Dmotley4/GimbalProject/BOM.JPG

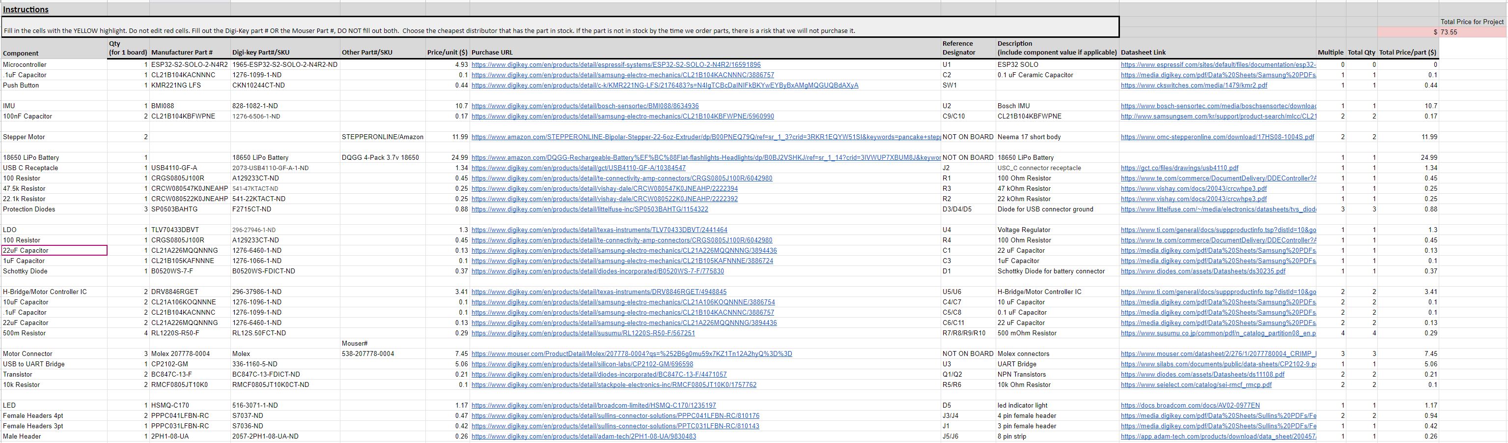
BOM.JPG
