Dmotley4/GimbalProject/Close_up_BOM.JPG

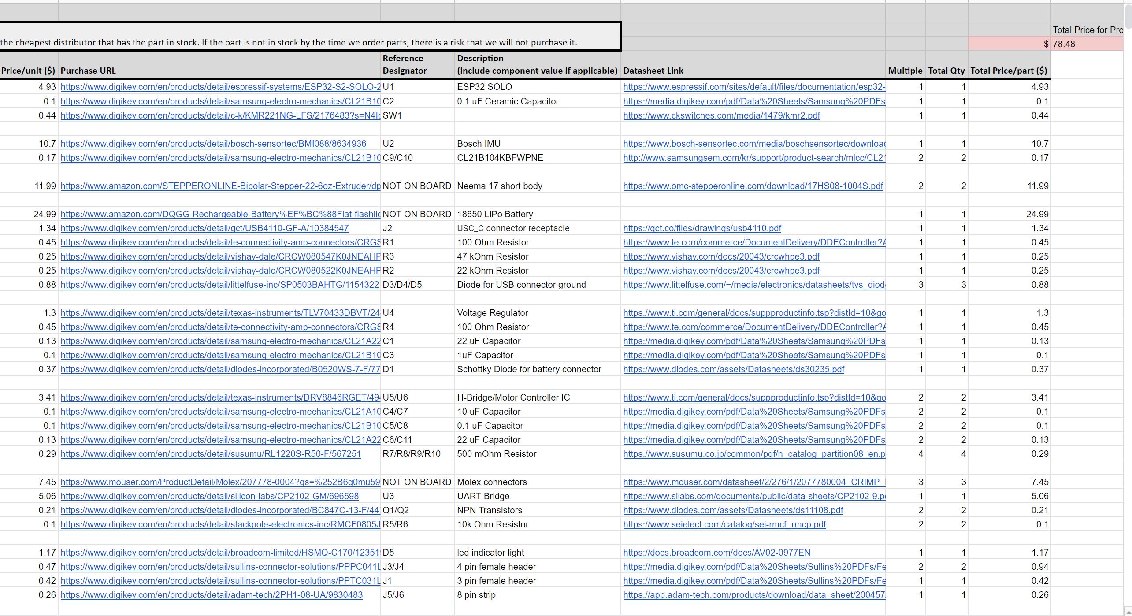
Close_up_BOM.JPG
