Dmotley4/GimbalProject/ProjectBOM - Google Sheets.pdf

Type | Product Name | Quantity | Price | Link Microcontroller | ESP32 | 1 | 4.69
.1uF Capacitor | CL21B104KACNNNC | 1 | 0.1 Push Button | TL2202EEZB | 1 | 0.42
IMU | Bosch IMU | 1 | 10.7
100nF Capacitor | 2 | 0.1
Stepper Motor | Neema 17 short body | 2 | 11.99
Battery | 18650 LiPo Battery | 1 | 24.99 USB C Receptacle | 1 | 1.34
100 Resistor | CRGS0805J100R | 1 | 0.45
47.5k Resistor | CRCW080547K0JNEAHP | 1 | 0.25
22.1k Resistor | CRCW080522K0JNEAHP | 1 | 0.25 Protection Diodes | SP0503BAHTG | 3 | 0.88
LDO | TLV70433DBVT | 1 | 1.3
100 Resistor | CRGS0805J100R | 1 | 0.45
22uF Capacitor | CL21A226MQQNNNG | 1 | 0.13
1uF Capacitor | CL21B105KAFNNNE | 1 | 0.1 Schottky Diode | B0520WS-7-F | 1 | 0.37
H-Bridge/Motor Controller IC | DRV8846RGET | 2 | 3.41
10uF Capacitor | CL21A106KOQNNNE | 2 | 0.1
.1uF Capacitor | CL21B104KACNNNC | 2 | 0.1
22uF Capacitor | CL21A226MQQNNNG | 2 | 0.13
500m Resistor | RL1220S-R50-F | 4 | 0.29
Motor Connector | Molex | 3 | 7.45 USB to UART Bridge | CP2103-GM | 1 | 6.76 Transistor | BC847C-13-F | 2 | 0.21
Total: | 76.96

https://www.digikey.com/en/products/detail/espressif-systems/ESP32-WROOM-32U-N16/9381721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
https://www.digikey.com/en/products/detail/e-switch/TL2202EEZB-GRN-ACT/16020087

https://www.digikey.com/en/products/detail/bosch-sensortec/BMI088/8634936
https://www.digikey.com/en/products/detail/samsung-electro-mechanics/CL05A104KA5NNNC/3886701

https://www.amazon.com/STEPPERONLINE-Bipolar-Stepper-22-6oz-Extruder/dp/B00PNEQ79Q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

https://www.amazon.com/DQGG-Rechargeable-Battery%EF%BC%88Flat-flashlights-Headlights/dp/B0BJ2VSHKJ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
https://www.digikey.com/en/products/detail/te-connectivity-amp-connectors/CRGS0805J100R/6042980
https://www.digikey.com/en/products/detail/vishay-dale/CRCW080547K0JNEAHP/2222394
https://www.digikey.com/en/products/detail/vishay-dale/CRCW080522K0JNEAHP/2222392https://www.digikey.com/en/products/detail/littelfuse-inc/SP0503BAHTG/1154322

https://www.digikey.com/en/products/detail/texas-instruments/TLV70433DBVT/2441464https://www.digikey.com/en/products/detail/te-connectivity-amp-connectors/CRGS0805J1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

https://www.digikey.com/en/products/detail/texas-instruments/DRV8846RGET/4948845https://www.digikey.com/en/products/detail/samsung-electro-mechanics/CL21A106KOQNNNE/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
https://www.digikey.com/en/products/detail/susumu/RL1220S-R50-F/567251

https://www.amazon.com/Molex-4-Circuits-Receptacle-Terminal-STANDARD/dp/B079CR36WX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 https://www.digikey.com/en/products/detail/silicon-labs/CP2103-GM/769478
https://www.digikey.com/en/products/detail/diodes-incorporated/BC847C-13-F/4471057

CL05A104KA5NNNC

USB4110-GF-A
