Dmotley4/GimbalProject/ProjectBOM.xlsx

Instructions
Fill in the cells with the YELLOW highlight. Do not edit red cells. Fill out the Digi-Key part # OR the Mouser Part #, DO NOT fill out both. Choose the cheapest distributor that has the part in stock. If the part is not in stock by the time we order parts, there is a risk that we will not purchase it. |  |  |  |  |  |  |  |  |  |  |  |  | Total Price for Project
 |  |  |  |  |  |  |  |  |  |  |  | $ | 114.16
Component | Qty (for 1 board) | Manufacturer Part # | Digi-key Part#/SKU | Other Part#/SKU | Price/unit ($) | Purchase URL | Reference Designator | Description (include component value if applicable) | Datasheet Link | Multiple | Total Qty | Total Price/part ($)
Push Button | 2 | KMR221NG LFS | CKN10244CT-ND |  | 0.44 | https://www.digikey.com/en/products/detail/c-k/KMR221NG-LFS/2176483?s=N4IgTCBcDaINIFkBKYwEYByBxAMgMQGUQBdAXyA | SW1/SW2 | Push button switch | https://www.ckswitches.com/media/1479/kmr2.pdf | 2 | 1 | 0.88
 |  |  |  |  |  |  |  |  |  |  |  | 0
Microcontroller | 1 | ESP32-S2-SOLO-2-N4R2 | 1965-ESP32-S2-SOLO-2-N4R2-ND |  | 4.93 | https://www.digikey.com/en/products/detail/espressif-systems/ESP32-S2-SOLO-2-N4R2/16591896 | U1 | ESP32 SOLO | https://www.espressif.com/sites/default/files/documentation/esp32-s2-solo-2_esp32-s2-solo-2u_datasheet_en.pdf | 0 | 1 | 0
IMU | 1 | BMI088 | 828-1082-1-ND |  | 10.7 | https://www.digikey.com/en/products/detail/bosch-sensortec/BMI088/8634936 | U2 | Bosch IMU | https://www.bosch-sensortec.com/media/boschsensortec/downloads/datasheets/bst-bmi088-ds001.pdf | 1 | 1 | 10.7
12V Buck Converter | 1 | LM2679SX-12 | LM2679SX-12/NOPBCT-ND |  | 6.97 | https://www.digikey.com/en/products/detail/texas-instruments/LM2679SX-12-NOPB/366925 | U3 | 12 v Buck | https://www.ti.com/lit/gpn/lm2679 | 1 | 1 | 6.97
LDO | 1 | TLV70433DBVT | 296-27946-1-ND |  | 1.3 | https://www.digikey.com/en/products/detail/texas-instruments/TLV70433DBVT/2441464 | U4 | Voltage Regulator | https://www.ti.com/general/docs/suppproductinfo.tsp?distId=10 | 1 | 1 | 1.3
H-Bridge/Motor Controller IC | 2 | DRV8846RGET | 296-37986-1-ND |  | 3.41 | https://www.digikey.com/en/products/detail/texas-instruments/DRV8846RGET/4948845 | U5/U6 | H-Bridge/Motor Controller IC | https://www.ti.com/general/docs/suppproductinfo.tsp?distId=10 | 2 | 2 | 6.82
 |  |  |  |  |  |  |  |  |  |  |  | 0
Stepper Motor | 2 |  |  | STEPPERONLINE/Amazon | 11.99 | https://www.amazon.com/STEPPERONLINE-Bipolar-Stepper-22-6oz-Extruder/dp/B00PNEQ79Q | NOT ON BOARD | Neema 17 short body | https://www.omc-stepperonline.com/download/17HS08-1004S.pdf | 2 | 2 | 23.98
Motor Connector | 3 | Molex 207778-0004 | Molex | 538-207778-0004 | 7.45 | https://www.mouser.com/ProductDetail/Molex/207778-0004?qs=%252B6g0mu59x7KZ1Tn12A2hyQ%3D%3D | NOT ON BOARD | Molex connectors | https://www.mouser.com/datasheet/2/276/1/2077780004_CRIMP_HOUSINGS-1622780.pdf | 1 | 3 | 7.45
Battery Holder | 1 | 18650 Battery Holder (4 slot) |  |  | 1.79 | https://www.amazon.com/Battery-Holder-Li-Ion-Envistia-Mall/dp/B07N51QLDK | NOT ON BOARD | 4 slot battery holder |  | 1 | 1 | 1.79
18650 LiPo Battery | 1 |  | 18650 LiPo Battery | DQGG 4-Pack 3.7v 18650 | 19.99 | https://www.amazon.com/Rechargeable-Batteries-Flashlight-Doorbells-Headlamps/dp/B0B1H6LZ77?hvadid=598281370702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 | NOT ON BOARD | 18650 LiPo Battery |  | 1 | 1 | 19.99
 |  |  |  |  |  |  |  |  |  |  |  | 0
USB C Receptacle | 1 | USB4125-GF-A | 2073-USB4125-GF-ACT-ND |  | 1.63 | https://www.digikey.com/en/products/detail/amphenol-cs-commercial-products/12401610E4-2A/5775519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 | J2 | USC_C connector receptacle | https://gct.co/files/drawings/usb4125.pdf?v=175f672b-2b35-4f58-b839-162846241683 | 1 | 1 | 1.63
Female Headers 4pt | 2 | PPPC041LFBN-RC | S7037-ND |  | 0.47 | https://www.digikey.com/en/products/detail/sullins-connector-solutions/PPPC041LFBN-RC/810176 | J3/J4 | 4 pin female header | https://media.digikey.com/pdf/Data%20Sheets/Sullins%20PDFs/Female_Headers.100_DS.pdf | 2 | 2 | 0.94
xt60 | 1 | PRT-10474 |  | 474-PRT-10474 | 1.5 | https://www.mouser.com/ProductDetail/SparkFun/PRT-10474?qs=WyAARYrbSnYJaRDMiD9g2w%3D%3D | J1 | xt60 connector/motor connector | https://www.mouser.com/datasheet/2/813/xt60-2490175.pdf | 1 | 1 | 1.5
Male Header | 1 | 2PH1-08-UA | 2057-2PH1-08-UA-ND |  | 0.26 | https://www.digikey.com/en/products/detail/adam-tech/2PH1-08-UA/9830483 | J5/J6 | 8 pin strip | https://app.adam-tech.com/products/download/data_sheet/200457/2ph1-xx-ua-data-sheet.pdf | 1 | 1 | 0.26
 |  |  |  |  |  |  |  |  |  |  |  | 0
15 uF Capacitor | 3 | C2012X5R1V156M125AC | 445-14423-1-ND |  | 4.6 | https://www.digikey.com/en/products/detail/tdk-corporation/C2012X5R1V156M125AC/3951659 | C12/C13/C14 |  | https://product.tdk.com/system/files/dam/doc/product/capacitor/ceramic/mlcc/catalog/mlcc_commercial_general_en.pdf | 1 | 10 | 4.6
22uF Capacitor | 1 | CL21A226MQQNNNG | 1276-6460-1-ND |  | 0.93 | https://www.digikey.com/en/products/detail/samsung-electro-mechanics/CL21A226MQQNNNG/3894436 | C1 | 22 uF Capacitor | https://media.digikey.com/pdf/Data%20Sheets/Samsung%20PDFs/CL21A226MQQNNNG_Spec.pdf | 1 | 10 | 0.93
1uF Capacitor | 1 | CL21B105KAFNNNE | 1276-1066-1-ND |  | 0.65 | https://www.digikey.com/en/products/detail/samsung-electro-mechanics/CL21B105KAFNNNE/3886724 | C3 | 1uF Capacitor | https://media.digikey.com/pdf/Data%20Sheets/Samsung%20PDFs/CL21B105KAFNNNE_Spec.pdf | 1 | 10 | 0.65
10uF Capacitor | 2 | CL21A106KOQNNNE | 1276-1096-1-ND |  | 0.74 | https://www.digikey.com/en/products/detail/samsung-electro-mechanics/CL21A106KOQNNNE/3886754 | C4/C7 | 10 uF Capacitor | https://media.digikey.com/pdf/Data%20Sheets/Samsung%20PDFs/CL21A106KOQNNNE_Spec.pdf | 1 | 10 | 0.74
100nF Capacitor | 2 | CL21B104KBFWPNE | 1276-6506-1-ND |  | 1.21 | https://www.digikey.com/en/products/detail/samsung-electro-mechanics/CL21B104KBFWPNE/5960990 | C9/C10 | CL21B104KBFWPNE | http://www.samsungsem.com/kr/support/product-search/mlcc/CL21B104KBFWPNE.jsp | 1 | 10 | 1.21
.1uF Capacitor | 4 | CL21B104KACNNNC | 1276-1099-1-ND |  | 0.37 | https://www.digikey.com/en/products/detail/samsung-electro-mechanics/CL21B104KACNNNC/3886757 | C2/C5/C8/C19 | 0.1 uF Capacitor | https://media.digikey.com/pdf/Data%20Sheets/Samsung%20PDFs/CL21B104KACNNNC_Spec.pdf | 1 | 10 | 0.37
22uF Capacitor | 2 | CL21A226MQQNNNG | 1276-6460-1-ND |  | 0.93 | https://www.digikey.com/en/products/detail/samsung-electro-mechanics/CL21A226MQQNNNG/3894436 | C6/C11 | 22 uF Capacitor | https://media.digikey.com/pdf/Data%20Sheets/Samsung%20PDFs/CL21A226MQQNNNG_Spec.pdf | 1 | 10 | 0.93
.01 uF Capacitor | 1 | CGA4J2X8R1H104K125AA | 445-5909-1-ND |  | 1.21 | https://www.digikey.com/en/products/detail/tdk-corporation/CGA4J2X8R1H104K125AA/2443387 | C16 |  | https://product.tdk.com/en/system/files | 1 | 10 | 1.21
180 uF Capacitor | 2 | EEU-FR1V181B | P15385CT-ND |  | 4.48 | https://www.digikey.com/en/products/detail/panasonic-electronic-components/EEU-FR1V181B/2504116 | C17/C18 |  | https://industrial.panasonic.com/cdbs/www-data/pdf/RDF0000/ABA0000C1259.pdf | 1 | 10 | 4.48
0.47 uF Capacitor | 1 | CL21B474KBFNFNE | 1276-2966-1-ND |  | 0.77 | https://www.digikey.com/en/products/detail/samsung-electro-mechanics/CL21B474KBFNFNE/3888624 | C15 |  | http://www.samsungsem.com/kr/support/product-search/mlcc/CL21B474KBFNFNE.jsp | 1 | 10 | 0.77
 |  |  |  | Mouser# |  |  |  |  |  |  |  | 0
100 Resistor | 2 | CRGS0805J100R | A129233CT-ND |  | 0.45 | https://www.digikey.com/en/products/detail/te-connectivity-amp-connectors/CRGS0805J100R/6042980 | R1/R4 | 100 Ohm Resistor | https://www.te.com/commerce/DocumentDelivery/DDEController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 | 4 | 2 | 1.8
500m Resistor | 4 | RL1220S-R50-F | RL12S.50FCT-ND |  | 2.45 | https://www.digikey.com/en/products/detail/susumu/RL1220S-R50-F/567251 | R/6R7/R8/R9 | 500 mOhm Resistor | https://www.susumu.co.jp/common/pdf/n_catalog_partition08_en.pdf | 1 | 10 | 2.45
10k Resistor | 2 | RMCF0805JT10K0 | RMCF0805JT10K0CT-ND |  | 0.18 | https://www.digikey.com/en/products/detail/stackpole-electronics-inc/RMCF0805JT10K0/1757762 | R5/R3 | 10k Ohm Resistor | https://www.seielect.com/catalog/sei-rmcf_rmcp.pdf | 1 | 10 | 0.18
5.6k Resistor | 1 | RMCF0805FT5K60 | MCF0805FT5K60CT-ND |  | 0.24 | https://www.digikey.com/en/products/detail/stackpole-electronics-inc/RMCF0805FT5K60/1760395 | R2 | 5.6k Ohm Resistor | https://www.seielect.com/catalog/sei-rmcf_rmcp.pdf | 1 | 10 | 0.24
 |  |  |  |  |  |  |  |  |  |  |  | 0
LED | 1 | HSMQ-C170 | 516-3071-1-ND |  | 1.17 | https://www.digikey.com/en/products/detail/broadcom-limited/HSMQ-C170/1235197 | D3 | led indicator light | https://docs.broadcom.com/docs/AV02-0977EN | 2 | 1 | 2.34
Schottky Diode | 1 | B0520WS-7-F | B0520WS-FDICT-ND |  | 0.37 | https://www.digikey.com/en/products/detail/diodes-incorporated/B0520WS-7-F/775830 | D1 | Schottky Diode for battery connector | https://www.diodes.com/assets/Datasheets/ds30235.pdf | 2 | 1 | 0.74
Diode | 1 | VS-6TQ045S-M3 | 112-VS-6TQ045S-M3-ND |  | 1.19 | https://www.digikey.com/en/products/detail/vishay-general-semiconductor-diodes-division/VS-6TQ045S-M3/5426222 | D2 | Diode for Buck Converter | https://www.vishay.com/docs/94945/vs-6tqs-m3.pdf | 2 | 1 | 2.38
 |  |  |  |  |  |  |  |  |  |  |  | 0
22 uH Inductor | 1 | ETQ-P4M220KVC | P19783CT-ND |  | 1.19 | https://www.digikey.com/en/products/detail/panasonic-electronic-components/ETQ-P4M220KVC/6134801 | L1 |  | https://industrial.panasonic.com/cdbs/www-data/pdf/AGL0000/AGL0000C63.pdf | 2 | 1 | 2.38
 |  |  |  |  |  |  |  |  |  | 1 |  | 0
PC Test Point | 5 | 5029 | 36-5029CT-ND |  | 0.31 | https://www.digikey.com/en/products/detail/keystone-electronics/5029/3904815 | TP1-TP5 | Test Point | https://www.keyelco.com/product-pdf.cfm?p=1358 | 5 | 3 | 1.55
 |  |  |  |  |  |  |  |  |  |  |  | 0
