Dmotley4/GimbalProject/Gimbal_Assembly.SLDASM

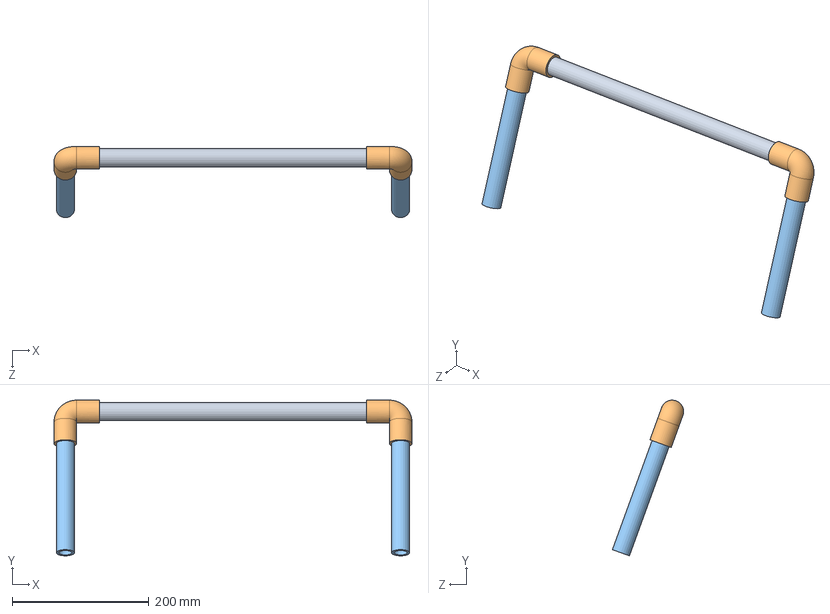
[picture p9: CAD file, 2022-11-11]
Gimbal_Assembly.SLDASM
523.7 x 227.8 x 104.3 mm
18_inch_pvc_white
ELBOW 90 Degree 19.0500 mm x 2
8_inch_pvc_white x 2
