Dmotley4/GimbalProject/8_inch_pvc_white.SLDPRT

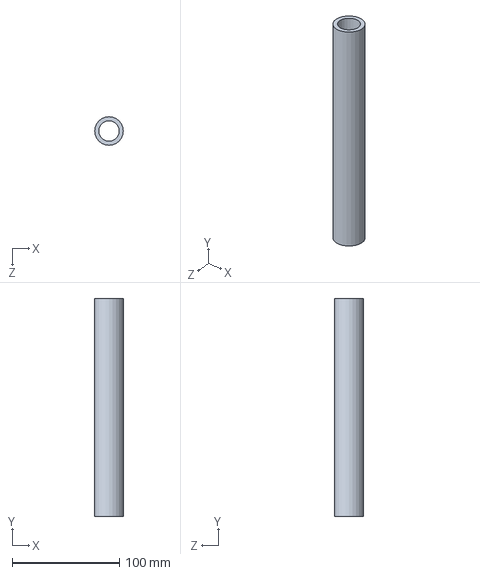
[picture p10: CAD file, 2022-11-11]
8_inch_pvc_white.SLDPRT
26.7 x 203.2 x 26.7 mm
