Dmotley4/GimbalProject/18_inch_pvc_white.SLDPRT

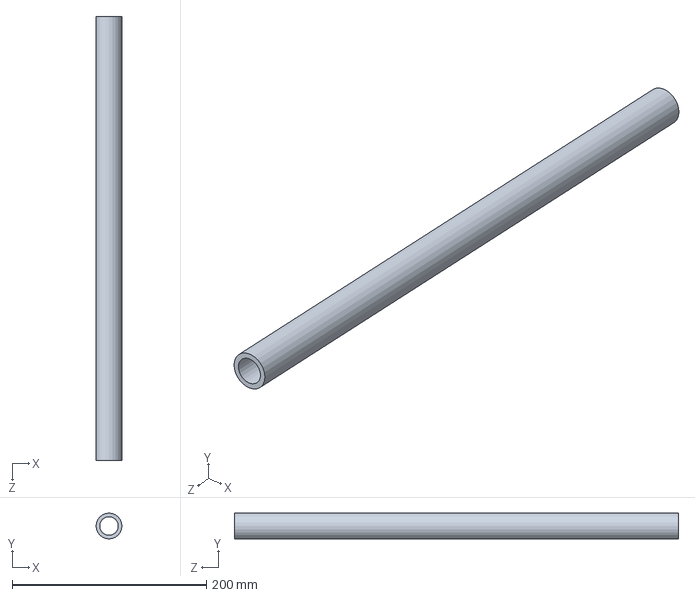
[picture p11: CAD file, 2022-11-11]
18_inch_pvc_white.SLDPRT
26.7 x 26.7 x 457.2 mm
