Dmotley4/GimbalProject/go10 d2.SLDPRT

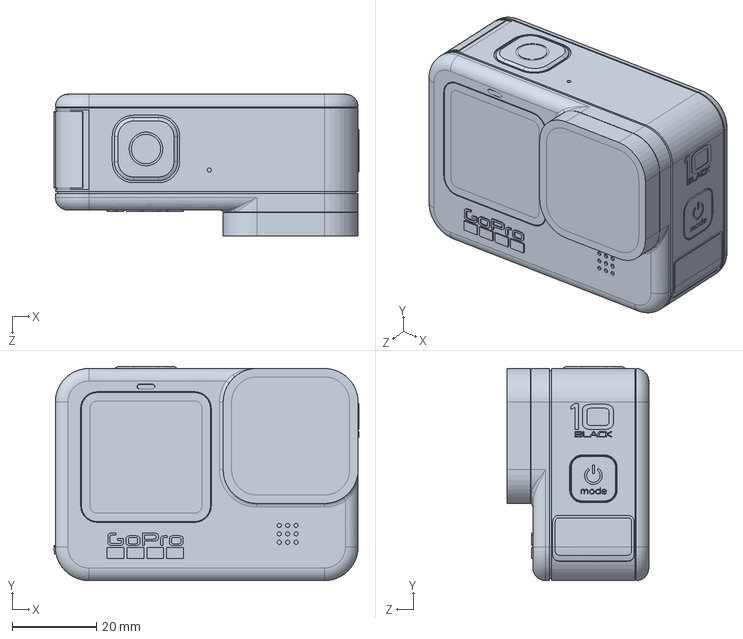
[picture p12: CAD file, 2022-11-11]
go10 d2.SLDPRT
72.3 x 50.8 x 33.6 mm
