Dmotley4/GimbalProject/ELBOW 90 Degree 19.0500 mm.SLDPRT

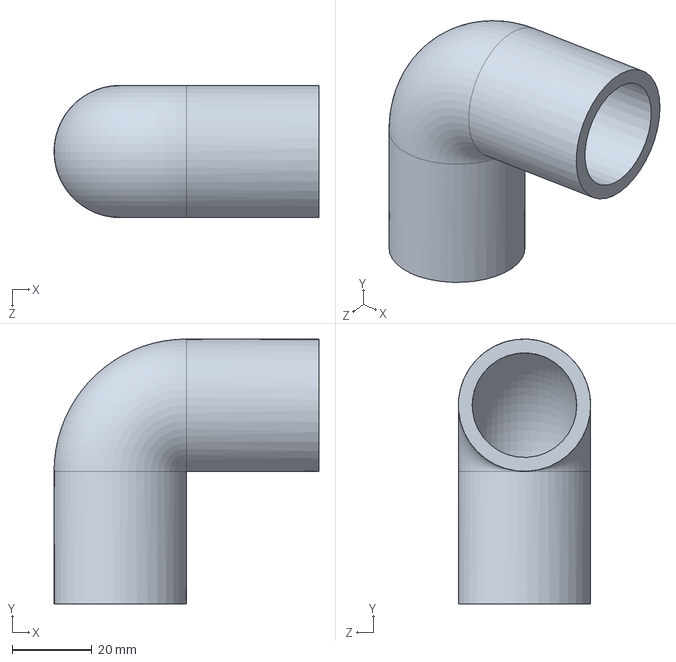
[picture p13: CAD file, 2022-11-11]
ELBOW 90 Degree 19.0500 mm.SLDPRT
66.6 x 66.6 x 33.3 mm
