Dmotley4/GimbalProject/1'pvc_white.SLDPRT

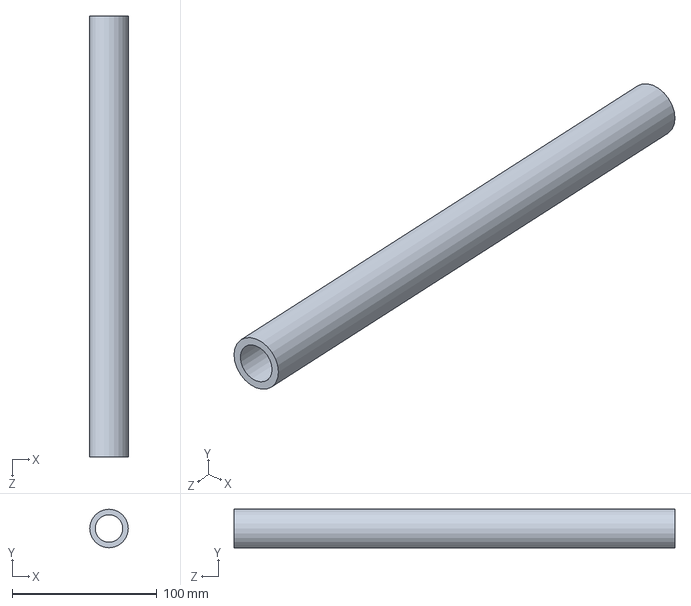
[picture p14: CAD file, 2022-11-11]
1'pvc_white.SLDPRT
26.7 x 26.7 x 304.8 mm
