Dmotley4/GimbalProject/Gimbal.pdf

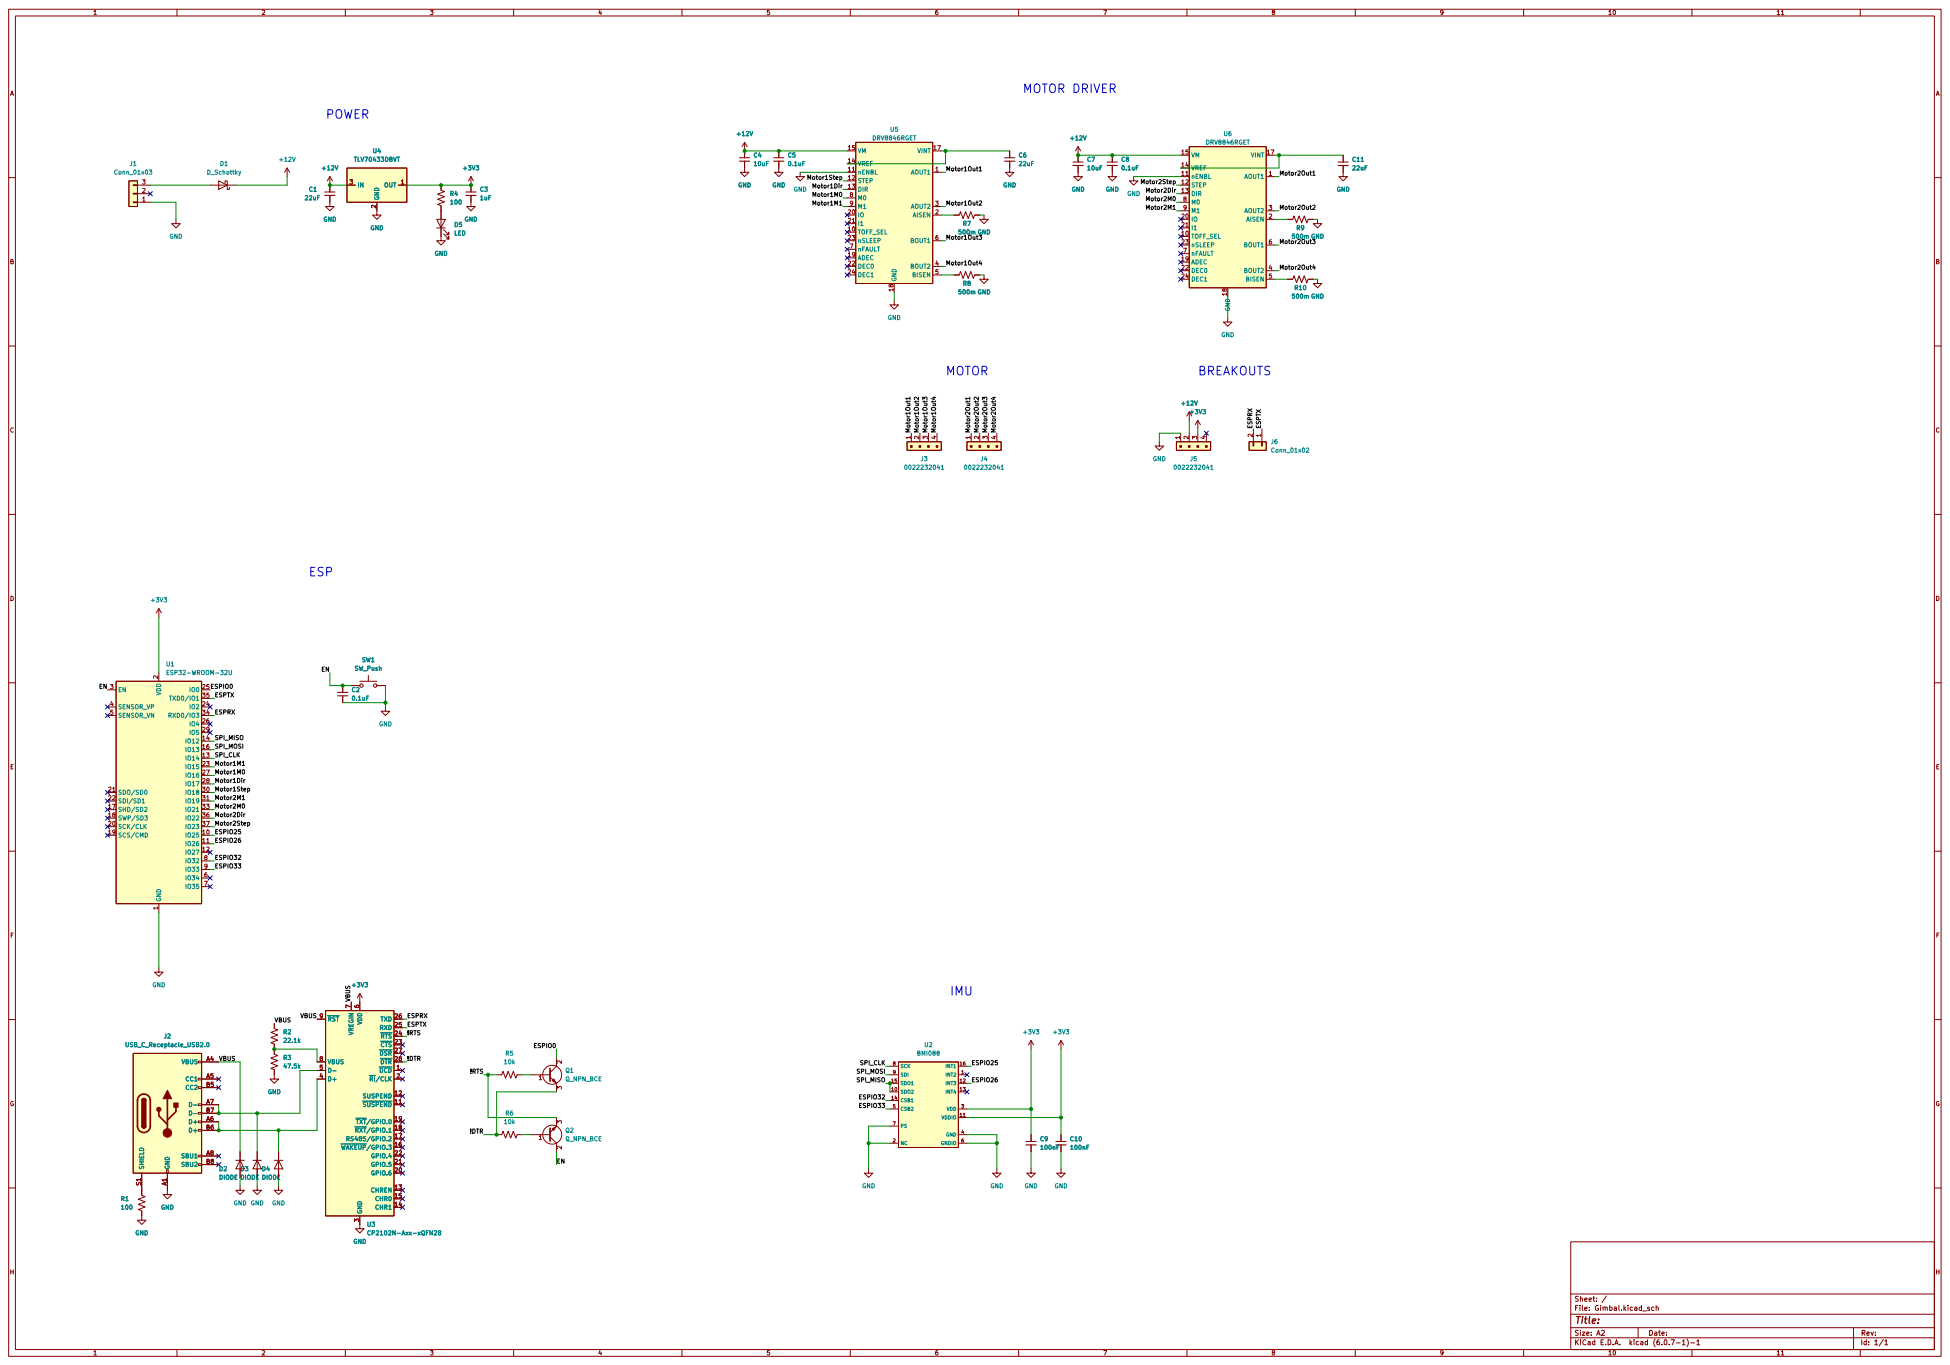
[picture p15: page 1]

2 SCK/CLK 20 SDO/SD0 21 SDI/SD1 22
ESPIO26 EN

D3 DIODE D2 DIODE GND GND
