Dmotley4/GimbalProject/Gimbal.kicad_pcb

## KiCad design Gimbal.kicad_pcb (2022-11-11)

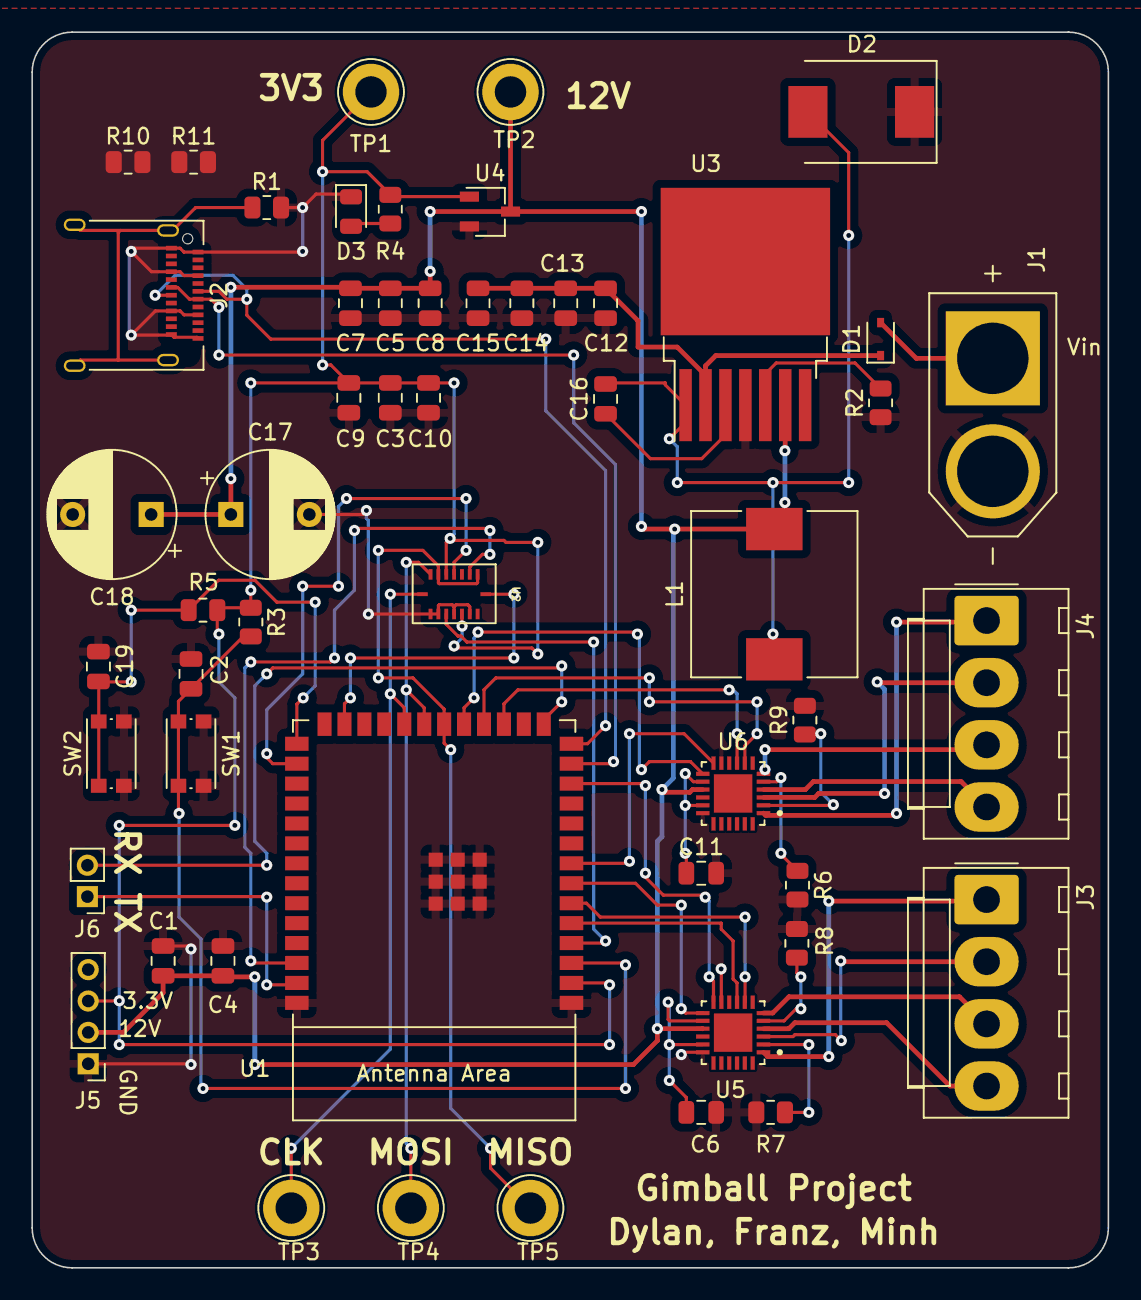
[picture p16: board Gimbal.kicad_pcb from above]

Board: 2 copper layers, 68.6 x 78.7 mm, 53 parts (0 on the bottom side), 45 nets.

Parts:
C1, C6, C11: 22uF; C_0805_2012Metric
C2, C5, C8, C19: 0.1uF; C_0805_2012Metric
C3: 1uF; C_0805_2012Metric
C4, C7: 10uF; C_0805_2012Metric
C9, C10: 100nF; C_0805_2012Metric
C12, C13, C14: 15uF; C_0805_2012Metric
C15: 0.47 uF; C_0805_2012Metric
C16: .01uF; C_0805_2012Metric
C17, C18: 180uF; CP_Radial_D8.0mm_P5.00mm
D1: D_Schottky; D_SOD-323
D2: DIODE; D_SMC
D3: LED; LED_0805_2012Metric
J1: XT60-M; AMASS_XT60-M
J2: USB_C_Receptacle_USB2.0; USB_C_Receptacle_Amphenol_12401610E4-2A
J3, J4: 0022232041; Molex_KK-396_A-41791-0004_1x04_P3.96mm_Vertical
J5: 0022232041; PinHeader_1x04_P2.00mm_Vertical
J6: Conn_01x02; PinHeader_1x02_P2.00mm_Vertical
L1: 22uH; L_10.4x10.4_H4.8
R1, R4: 100; R_0805_2012Metric
R2: 5.6k; R_0805_2012Metric
R3, R5, R10, R11: 10k; R_0805_2012Metric
R6, R7, R8, R9: 500m; R_0805_2012Metric
SW1, SW2: SW_Push; SW_Push_1P1T_NO_CK_KMR2
TP1, TP2, TP3, TP4, TP5: TestPoint; TestPoint_Loop_D3.80mm_Drill2.0mm
U1: ESP32-S2-SOLO
U2: BMI088
U3: LM2679SX-12; TO-263-7_TabPin8
U4: TLV70433DBVT; TSOT-23
U5, U6: DRV8846RGET; QFN50P400X400X100-25N

Connections:
+3V3: C3.1, C9.1, C10.1, J5.3, R3.1, R4.1, R5.1, TP1.1, U1.2 (3V3), U2.3 (VDD), U2.11 (VDDIO), U4.1 (OUT)
+12V: C1.1, C4.1, C5.1, C7.1, C8.1, C17.1, C18.1, J5.2, L1.2, TP2.1, U3.6 (FB), U4.3 (IN), U5.15 (VM), U6.15 (VM)
+BATT: C12.1, C13.1, C14.1, C15.1, D1.1 (K), U3.2 (INPUT)
/BUCKCB: C16.1, U3.3 (CB)
/D+: J2.A6 (D+), J2.B6 (D+), U1.14 (GPIO20/U1CTS/ADC2_CH9/CLK_OUT1/USB_D+)
/D-: J2.A7 (D-), J2.B7 (D-), U1.13 (GPIO19/U1RTS/ADC2_CH8/CLK_OUT2/USB_D-)
/EN: C2.2, R3.2, SW1.1, U1.3 (EN)
/ESPIO0: C19.2, R5.2, SW2.1, U1.27 (GPIO0)
/ESPIO2: U1.38 (GPIO2/TOUCH2/ADC1_CH1), U2.14 (CSB1)
/ESPIO4: U1.4 (GPIO4/TOUCH4/ADC1_CH3), U2.5 (CSB2)
/ESPIO34: U1.25 (SPIIO5/GPIO34/FSPICS0), U2.16 (INT1)
/ESPIO35: U1.28 (SPIIO6/GPIO35/FSPID), U2.12 (INT3)
/ESPRX: J6.2, U1.15 (GPIO3/TOUCH3/ADC1_CH2)
/ESPTX: J6.1, U1.39 (GPIO1/TOUCH1/ADC1_CH0)
/Motor1Dir: U1.7 (GPIO7/TOUCH7/ADC1_CH6), U5.13 (DIR)
/Motor1M0: U1.6 (GPIO6/TOUCH6/ADC1_CH5), U5.8 (M0)
/Motor1M1: U1.5 (GPIO5/TOUCH5/ADC1_CH4), U5.9 (M1)
/Motor1Out1: J3.1, U5.1 (AOUT1)
/Motor1Out2: J3.2, U5.3 (AOUT2)
/Motor1Out3: J3.3, U5.6 (BOUT1)
/Motor1Out4: J3.4, U5.4 (BOUT2)
/Motor1Step: U1.12 (GPIO8/TOUCH8/ADC1_CH7), U5.12 (STEP)
/Motor2Dir: U1.19 (GPIO11/TOUCH11/ADC2_CH0/FSPID/FSPIIO5), U6.13 (DIR)
/Motor2M0: U1.18 (GPIO10/TOUCH10/ADC1_CH9/FSPICS0/FSPIIO4), U6.8 (M0)
/Motor2M1: U1.17 (GPIO9/TOUCH9/ADC1_CH8/FSPIHD), U6.9 (M1)
/Motor2Out1: J4.1, U6.1 (AOUT1)
/Motor2Out2: J4.2, U6.3 (AOUT2)
/Motor2Out3: J4.3, U6.6 (BOUT1)
/Motor2Out4: J4.4, U6.4 (BOUT2)
/Motor2Step: U1.8 (GPIO15/U0RTS/ADC2_CH4/XTAL_32K_P), U6.12 (STEP)
/SPI_CLK: TP3.1, U1.22 (GPIO14/TOUCH14/ADC2_CH3/FSPIWP/FSPIDQS), U2.8 (SCK)
/SPI_MISO: TP5.1, U1.20 (GPIO12/TOUCH12/ADC2_CH1/FSPICLK/FSPIIO6), U2.10 (SDO2), U2.15 (SDO1)
/SPI_MOSI: TP4.1, U1.21 (GPIO13/TOUCH13/ADC2_CH2/FSPIQ/FSPIIO7), U2.9 (SDI)
GND: C1.2, C2.1, C3.2, C4.2, C5.2, C6.2, C7.2, C8.2, C9.2, C10.2, C11.2, C12.2, C13.2, C14.2, C15.2, C17.2, C18.2, C19.1, D2.1 (A), D3.1 (K), J1.N (NEG), J2.A1 (GND), J2.A4 (VBUS), J2.A9 (VBUS), J2.A12 (GND), J2.B1 (GND), J2.B4 (VBUS), J2.B9 (VBUS), J2.B12 (GND), J5.1, R1.2, R2.1, R6.2, R7.2, R8.2, R9.2, R10.2, R11.2, SW1.2, SW2.2, U1.1 (GND), U1.40 (GND), U1.41 (GND), U2.2 (NC), U2.4 (GND), U2.6 (GNDIO), U2.7 (PS), U3.4 (GND), U4.2 (GND), U5.11 (nENBL), U5.18 (GND), U6.11 (nENBL), U6.18 (GND)
unnamed: C6.1, U5.14 (VREF), U5.17 (VINT)
unnamed: C11.1, U6.14 (VREF), U6.17 (VINT)
unnamed: C16.2, D2.2 (K), L1.1, U3.1 (SWITCH_OUTPUT)
unnamed: D1.2 (A), J1.P (POS)
unnamed: D3.2 (A), R4.2
unnamed: J2.S1 (SHIELD), R1.1
unnamed: R2.2, U3.5 (CURRENT_ADJ)
unnamed: R6.1, U6.5 (BISEN)
unnamed: R7.1, U5.2 (AISEN)
unnamed: R8.1, U5.5 (BISEN)
unnamed: R9.1, U6.2 (AISEN)
