Dmotley4/GimbalProject/(commit log)

2022-10-22 fixed boot pin
    [Gimbal.kicad_sch]
2022-10-25 finished erc check
    [Gimbal.kicad_sch]
2022-10-25 filled in schematic
    [Gimbal.kicad_sch]
2022-10-25 draft submission
    [Gimbal.kicad_sch]
2022-11-03 changed esp to solo s2
    [Gimbal.kicad_sch]
2022-11-03 assigned all footprints
    [Gimbal.kicad_sch]
2022-11-03 preliminary layout
    [Gimbal.kicad_pcb]
2022-11-03 prelim routing
    [Gimbal.kicad_pcb]
2022-11-04 routing actually good
    [Gimbal.kicad_pcb, Gimbal.kicad_sch]
2022-11-04 new schematic
    [Gimbal.kicad_pcb, Gimbal.kicad_sch]
2022-11-04 started new layout
    [Gimbal.kicad_pcb, Gimbal.kicad_sch]
2022-11-10 New layout
    [Gimbal.kicad_pcb]
2022-11-10 fixing schematic erc issues and adding test points
    [Gimbal.kicad_sch]
2022-11-11 schematic changes
2022-11-11 updated layout and schematic to fix errors
    [Gimbal.kicad_pcb, Gimbal.kicad_sch]
2022-11-11 Changed numbering
    [Gimbal.kicad_sch]
2022-11-11 layout completed
    [Gimbal.kicad_pcb, Gimbal.kicad_sch]
2022-11-11 Fixed USB connector issues
    [Gimbal-B_Cu.gbl, Gimbal-B_Mask.gbs, Gimbal-B_Paste.gbp, Gimbal-B_Silkscreen.gbo, Gimbal-Edge_Cuts.gm1, Gimbal-F_Cu.gtl, Gimbal-F_Mask.gts, Gimbal-F_Paste.gtp]
